Ploos-AS/C64RS232/qualification/M1_10_QUALIFICATION.md

# M1.10 Qualification

Status: PASS

Qualified by GitHub Actions on source commit 8b87d77f5c7bfc755b27fd41c38d2ce8a6400ac1.

- M1.10 physical-part and footprint audit: PASS
- M1.7 native schematic regression: PASS
- M1.9 electrical-net/ERC qualification: PASS
- J2 footprint: C64RS232:TE_5747844-4
