Ploos-AS/C64RS232/qualification/M2_1_QUALIFICATION.md

# M2.1 Qualification

Status: PASS

Qualified by GitHub Actions on source commit 8b87d77f5c7bfc755b27fd41c38d2ce8a6400ac1.

- Native KiCad PCB generation: PASS
- M2.1 structural PCB qualification: PASS
- 2 copper layers; 1.57 mm nominal PCB
- Nine frozen M1.10 footprints present exactly once
- Closed provisional Edge.Cuts and J1/J2 mechanical anchors: PASS
- Routing and copper zones intentionally deferred to M2.2/M2.3
