Ploos-AS/C64RS232/hardware/C64RS232_M1.kicad_sch

## KiCad design hardware/C64RS232_M1.kicad_sch (2026-09-17)

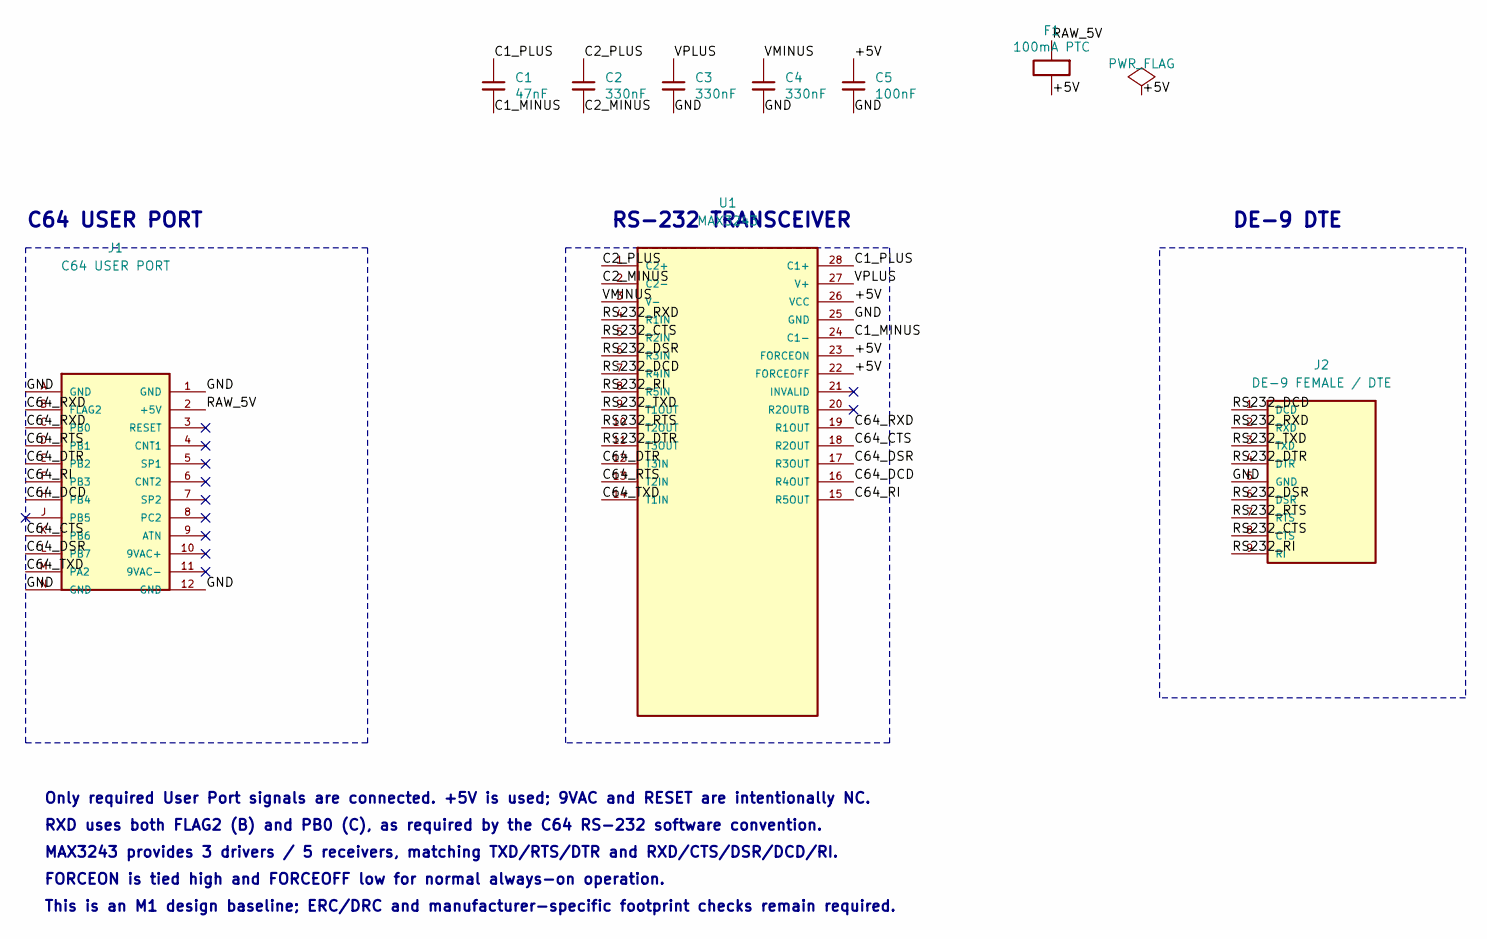
[picture p1: schematic C64RS232_M1.kicad_sch]

Parts:
C1: 47nF
C2, C3, C4: 330nF
C5: 100nF
F1: 100mA PTC
J1: C64 USER PORT
J2: DE-9 FEMALE / DTE
U1: MAX3243

Connections:
+5V: C5.1, F1.2, U1.22 (FORCEOFF), U1.23 (FORCEON), U1.26 (VCC)
C1_MINUS: C1.2, U1.24 (C1-)
C1_PLUS: C1.1, U1.28 (C1+)
C2_MINUS: C2.2, U1.2 (C2-)
C2_PLUS: C2.1, U1.1 (C2+)
C64_CTS: J1.K (PB6), U1.18 (R2OUT)
C64_DCD: J1.H (PB4), U1.16 (R4OUT)
C64_DSR: J1.L (PB7), U1.17 (R3OUT)
C64_DTR: J1.E (PB2), U1.12 (T3IN)
C64_RI: J1.F (PB3), U1.15 (R5OUT)
C64_RTS: J1.D (PB1), U1.13 (T2IN)
C64_RXD: J1.B (FLAG2), J1.C (PB0), U1.19 (R1OUT)
C64_TXD: J1.M (PA2), U1.14 (T1IN)
GND: C3.2, C4.2, C5.2, J1.1 (GND), J1.12 (GND), J1.A (GND), J1.N (GND), J2.5 (GND), U1.25 (GND)
RAW_5V: F1.1, J1.2 (+5V)
RS232_CTS: J2.8 (CTS), U1.5 (R2IN)
RS232_DCD: J2.1 (DCD), U1.7 (R4IN)
RS232_DSR: J2.6 (DSR), U1.6 (R3IN)
RS232_DTR: J2.4 (DTR), U1.11 (T3OUT)
RS232_RI: J2.9 (RI), U1.8 (R5IN)
RS232_RTS: J2.7 (RTS), U1.10 (T2OUT)
RS232_RXD: J2.2 (RXD), U1.4 (R1IN)
RS232_TXD: J2.3 (TXD), U1.9 (T1OUT)
VMINUS: C4.1, U1.3 (V-)
VPLUS: C3.1, U1.27 (V+)

Notes on the sheet:
RS-232 TRANSCEIVER
MAX3243 provides 3 drivers / 5 receivers, matching TXD/RTS/DTR and RXD/CTS/DSR/DCD/RI.
DE-9 DTE
RXD uses both FLAG2 (B) and PB0 (C), as required by the C64 RS-232 software convention.
This is an M1 design baseline; ERC/DRC and manufacturer-specific footprint checks remain required.
FORCEON is tied high and FORCEOFF low for normal always-on operation.
C64 USER PORT
Only required User Port signals are connected. +5V is used; 9VAC and RESET are intentionally NC.
