Ploos-AS/C64RS232/(commit log)

2026-09-14 Add M1 KiCad legacy schematic baseline
    [C64RS232_M1.sch]
2026-09-14 Add M1 cached KiCad symbols
2026-09-14 Add M1 hardware BOM
    [BOM_M1.csv]
2026-09-14 Define M1.2 native KiCad implementation plan
2026-09-14 Define C64RS232 M2 PCB placement baseline
2026-09-14 Add native KiCad project baseline
2026-09-14 Record M1.3 native KiCad project baseline
2026-09-14 Add native KiCad project gate
2026-09-14 Document M1.4 native KiCad gate
2026-09-14 Add reproducible KiCad schematic upgrade helper
2026-09-14 Add KiCad schematic validation workflow
2026-09-14 Fix KiCad 7 schematic validation helper
2026-09-14 Run supported KiCad legacy schematic validation in CI
2026-09-14 Use KiCad 9 CLI to convert and validate native schematic
2026-09-14 Use KiCad 9 CI and persist native schematic
2026-09-14 Fix KiCad 9 legacy conversion using Eeschema GUI
2026-09-14 Run legacy schematic conversion headlessly with Eeschema
2026-09-14 Fix KiCad CI headless setup
2026-09-14 Make KiCad legacy conversion share one virtual display
2026-09-14 Harden KiCad GUI conversion against hangs
2026-09-14 Add diagnostics and timeout to KiCad CI
2026-09-14 Handle KiCad first-run library dialog in headless conversion
2026-09-14 Handle KiCad legacy symbol remap dialog
2026-09-14 Click KiCad Remap Symbols action explicitly
2026-09-15 Handle KiCad Project Rescue Helper dialog
2026-09-15 Fix KiCad rescue dialog click target
2026-09-15 Fix KiCad save without a window manager
2026-09-15 Close completed KiCad remap dialog before saving
2026-09-15 Preserve native KiCad schematic when ERC fails
2026-09-15 Preserve generated native KiCad schematic as artifact
2026-09-15 Preserve native KiCad schematic from CI conversion
    [C64RS232_M1.kicad_sch]
2026-09-15 Remove placeholder native schematic
    [C64RS232_M1.kicad_sch]
2026-09-15 Commit native KiCad schematic before ERC enforcement
2026-09-15 Add generated native KiCad M1 schematic
    [C64RS232_M1.kicad_sch]
2026-09-15 Define M1.7 electrical wiring contract
2026-09-15 Add M1.7 wiring contract checker
2026-09-15 Generate M1.8 electrical connectivity in legacy schematic
2026-09-15 Generate connected M1.8 schematic before KiCad conversion
2026-09-15 Generate electrically connected KiCad M1.8 schematic
    [C64RS232_M1.kicad_sch, C64RS232_M1.sch]
2026-09-16 Fix M1.8 KiCad XML netlist parsing
2026-09-16 Make M1.8 wiring generator idempotent
2026-09-16 Normalize hierarchical KiCad net names in M1.8 check
2026-09-16 Fix M1.8b ERC electrical pin types
2026-09-16 Fix M1.8b power protection connectivity
2026-09-16 Fix C64 power source pin types for ERC
2026-09-16 Add local PWR_FLAG symbol for protected 5V rail
2026-09-16 Drive protected 5V rail explicitly for ERC
2026-09-16 Verify exact M1.8c functional pin connectivity
2026-09-16 Support KiCad S-expression netlist pin assertions
2026-09-16 Qualify M1.8d power and charge-pump connectivity
2026-09-16 Fix M1.8d KiCad netlist semantics
2026-09-16 Correct MAX3243E control and 5V capacitor baseline
2026-09-16 Verify MAX3243E always-on control wiring
2026-09-16 Lock MAX3243EIPWR and 5V charge-pump values
    [BOM_M1.csv]
2026-09-17 Start M1.10 footprint and mechanical gate
2026-09-17 Record M1.9 and start M1.10 footprint gate
2026-09-17 Slim KiCad CI dependencies and extend install timeout
2026-09-17 Fix minimal KiCad package installation
2026-09-17 Generate electrically connected KiCad M1.9 schematic
    [C64RS232_M1.kicad_sch]
2026-09-17 Add M1.10 C64 User Port edge footprint baseline
2026-09-17 Add M1.10 User Port footprint audit
2026-09-17 Run M1.10 User Port footprint audit in CI
2026-09-17 Assign frozen M1.10 KiCad footprints
2026-09-17 Verify M1.10 schematic footprint assignments
2026-09-17 Run M1.10 audit after footprint generation
2026-09-17 Generate M1.10 KiCad schematic baseline
    [C64RS232_M1.kicad_sch, C64RS232_M1.sch]
2026-09-17 Correct C64 User Port mating finger geometry
2026-09-17 Audit corrected C64 edge finger geometry
2026-09-18 Add KiCad manufacturing package CI
2026-09-18 Add vendor-neutral PCB ordering guide
2026-09-18 Link PCB ordering guide
2026-09-18 Link PCB ordering options from README
2026-09-18 Add maker-friendly KiCad design lint
2026-09-18 Add maker-friendly PCB manufacturer profiles
2026-09-18 Add maker-friendly component and BOM policy
2026-09-18 Add maker-friendly BOM lint to manufacturing CI
2026-09-18 Freeze M1.10 capacitor and protection BOM
    [BOM_M1.csv]
2026-09-18 Document M1.10 J2 mismatch and capacitor freeze
2026-09-18 Audit frozen M1.10 BOM requirements
2026-09-18 Add exact TE 5747844-4 footprint baseline
2026-09-18 Assign exact TE 5747844-4 footprint
2026-09-18 Audit TE 5747844-4 project footprint
2026-09-18 Enable manual KiCad qualification dispatch
2026-09-18 Mark exact J2 footprint gate resolved
2026-09-18 ci: pin hardware workflow to v1
2026-09-19 Strengthen M1.10 footprint qualification
2026-09-19 Fix KiCad workflow dispatch syntax
2026-09-19 Simplify KiCad workflow triggers
2026-09-19 Reduce KiCad workflow to syntax smoke test
2026-09-19 Fix KiCad package install command
2026-09-19 Fix J2 footprint parser regex
2026-09-19 Complete M1 and start M2 PCB layout
2026-09-19 Define M2.1 PCB mechanical placement gate
2026-09-19 Add M2.1 native PCB baseline generator
2026-09-19 Exercise M2.1 PCB generation in CI
2026-09-19 Generate M2.1 PCB through KiCad headless GUI
2026-09-19 Capture M2.1 KiCad post-F8 diagnostics
2026-09-19 Replace brittle GUI PCB generation with deterministic M2.1 skeleton
2026-09-19 Add M2.1 PCB structural qualification
2026-09-19 Enforce M2.1 PCB structural gate in CI
2026-09-19 Start M2.2 power and charge-pump copper baseline
2026-09-19 Add M2.2 power and charge-pump qualification
2026-09-19 Define M2.3 signal routing and GND plane contract
2026-09-19 Correct C64 User Port RS-232 signal mapping
    [C64RS232_M1.kicad_sch]
2026-09-19 Complete and sanitize C64 User Port pin mapping
    [C64RS232_M1.kicad_sch]
2026-09-19 Repair C64 User Port mapping with valid KiCad objects
    [C64RS232_M1.kicad_sch]
2026-09-19 Preserve C64 B+C RXD and correct unused-pin gate
2026-09-19 Restore electrically connected M1.9 schematic baseline
    [C64RS232_M1.kicad_sch]
2026-09-19 Handle normalized KiCad coordinates in M2.3 J1 gate
2026-09-19 Compare KiCad J1 coordinates numerically
2026-09-19 Add M2.3 signal routing and GND plane baseline
2026-09-19 Qualify M2.3 signal routes and B.Cu GND plane
2026-09-19 Enforce M2.3 routing and GND-plane gate
2026-09-19 Probe pcbnew Python support for real M2 PCB generation
2026-09-19 Require KiCad parser and real pads for M2 PCB
2026-09-19 Freeze expected real M2 footprint pad inventory
2026-09-19 Start loading real KiCad footprints for M2 PCB
2026-09-19 Use KiCad 9 FootprintSave API correctly
2026-09-19 Fix real-footprint generator Python syntax
2026-09-19 Replace broken real-footprint generator function
2026-09-19 Serialize real footprints through temporary KiCad board
2026-09-19 Accept native KiCad footprint names in M2.1 gate
2026-09-19 Assign physical connector and fuse pad nets
2026-09-19 Assign MAX3243E and charge-pump pad nets
2026-09-19 Qualify complete MAX3243E and capacitor pad nets
2026-09-19 Add charge-pump nets to physical pad map
2026-09-19 Reject floating structural copper in M2 PCB
2026-09-19 Remove floating placeholder copper from M2 PCB
2026-09-20 Route physical M2.2 power and charge pump nets
2026-09-20 Route physical local GND bypass copper
2026-09-20 Remove invalid J1 GND copper assumptions
2026-09-20 Make M2.3 GND zone gate native-KiCad tolerant
2026-09-20 Restore physical B.Cu GND zone to M2 PCB
2026-09-20 Add M2.4 mechanical footprint gate
2026-09-20 Make M2.4 coordinate gate KiCad-format tolerant
2026-09-20 Validate M2.4 anchors through KiCad parser
2026-09-20 Validate J1 pad geometry through KiCad parser
2026-09-20 Add native KiCad PCB DRC gate for M2.5
2026-09-20 Expose KiCad DRC report on failure
2026-09-20 Route C64 User Port signals on connector copper side
2026-09-20 Stitch SMD ground pads into B.Cu plane
2026-09-20 Complete explicit GND connectivity for DRC
2026-09-20 Normalize KiCad coordinates in copper graph gate
2026-09-20 Recognize through-hole pad anchors in copper graph
2026-09-20 Use native KiCad DRC as copper connectivity authority
2026-09-20 Fan out C64 signals before layer transitions
2026-09-20 Reposition MAX3243E charge-pump capacitors
2026-09-20 Repair charge-pump and ground connectivity
2026-09-20 Close remaining explicit GND connection
2026-09-20 Fan out User Port traces before C64 routing
2026-09-20 Remove transverse GND rail from User Port fanout
2026-09-20 Route User Port grounds around board perimeter
2026-09-20 Fan out MAX3243E supply pins to external rail
2026-09-20 Move MAX3243E supply rail outside charge-pump fanout
2026-09-20 Move supply collection rail clear of C64 channels
2026-09-20 Separate C64 signal routing from back-layer power
2026-09-20 Orthogonalize MAX3243E charge-pump fanout
2026-09-20 Remove transverse top-layer ground through charge pump
2026-09-20 Reconnect local ground branches after cleanup
2026-09-20 Reconnect isolated ground branch
2026-09-20 Remove redundant long ground branch
2026-09-20 Restore compact C4 ground connection
2026-09-20 Remove stray non-GND via from C4 branch
2026-09-20 Add M2.4 fabrication silkscreen
2026-09-20 Enforce M2.4 silkscreen gate
2026-09-20 Move M2 +5V distribution to local front-layer spine
2026-09-20 Revert unsuccessful front-layer power experiment
2026-09-20 Remove redundant M2 ground routes and duplicate vias
2026-09-21 Untangle lower RS232 connector fanout
2026-09-21 Record PCB and generator fingerprints before DRC
2026-09-21 Make generated footprint UUIDs deterministic
2026-09-21 Fix footprint serialization join string
2026-09-21 Preserve quoted KiCad UUID syntax
2026-09-21 Normalize KiCad UUIDs using native unquoted syntax
2026-09-21 Restore native KiCad footprint serialization
2026-09-21 Restore known-good M2 PCB generator
2026-09-21 Use KiCad API for M2.1 footprint qualification
2026-09-21 Verify deterministic M2 PCB generation in CI
2026-09-21 Report nondeterministic PCB generation diff
2026-09-21 Compare canonical M2 PCB geometry in CI
2026-09-21 Move local 5V distribution to front copper
2026-09-21 Revert front copper 5V experiment
2026-09-21 Route VMINUS clear of C4 ground pad
2026-09-21 Separate C2 charge-pump traces
2026-09-21 Revert C2 trace detour
2026-09-21 Route VPLUS around C1 charge-pump trace
2026-09-21 Move local GND via clear of 5V
2026-09-22 Revert local GND via experiment
2026-09-22 Move 5V bypass via clear of C64 RXD
2026-09-22 Move second 5V via clear of C64 RXD
2026-09-22 Revert second 5V via experiment
2026-09-22 Route RS232 RI around J2 ground
2026-09-22 Move 5V layer transition below C64 DSR
2026-09-22 Revert 5V DSR transition experiment
2026-09-23 Route C64 TXD around power corridor
2026-09-23 Route C64 RXD below power fanout
2026-09-24 Separate C2 charge pump traces
2026-09-24 Revert C2 charge pump routing experiment
2026-09-24 Fan out C2 charge pump pair locally
2026-09-24 Detour 5V around local ground vias
2026-09-24 Revert 5V ground-via detour
2026-09-24 Respace local 5V fanout around ground vias
2026-09-25 Revert 5V fanout respacing experiment
2026-09-25 Simplify local ground breakout around U1
2026-09-25 Refine simplified U1 ground breakout
2026-09-25 Clear U1 CTS and RI from ground breakout
2026-09-25 Route C4 ground below VMINUS corridor
2026-09-25 Revert lower C4 ground route
2026-09-25 Increase C2 charge-pump separation
2026-09-25 Lift VMINUS clear of ground corridor
2026-09-26 Move right ground breakout clear of 5V rail
2026-09-26 Revert right ground breakout move
2026-09-26 Detour C64 RI around 5V fanout
2026-09-27 Route C64 RI inside 5V bypass via
2026-09-27 Shift vertical 5V rail clear of ground breakout
2026-09-27 Revert vertical 5V rail shift
2026-09-27 Keep right ground breakout outside 5V rail
2026-09-27 Move outer ground via clear of C64 DSR
2026-09-27 Route local ground below VMINUS
2026-10-03 Fan out left U1 RS232 signal bank
2026-10-03 Lower local GND route below RS232 DSR
2026-10-03 Nudge local GND clear of RS232 CTS
2026-10-04 Restore best local GND clearance point
2026-10-04 Lift RS232 CTS escape above local GND
2026-10-04 Route local GND around U1 RS232 pads
2026-10-04 Revert GND route through charge-pump corridor
2026-10-04 Drop C4 ground directly to plane
2026-10-04 Revert C4 direct ground-plane drop
2026-10-04 Jog local GND below RS232 CTS pad
2026-10-05 Square GND jog clear of RS232 CTS escape
2026-10-05 Ground C3 and C5 into back-plane
2026-10-06 Revert unsafe C3 C5 ground vias
2026-10-06 Fill copper zones before native PCB DRC
